alexanderp4580/slonav/parts/Sensor_Bracket.stl

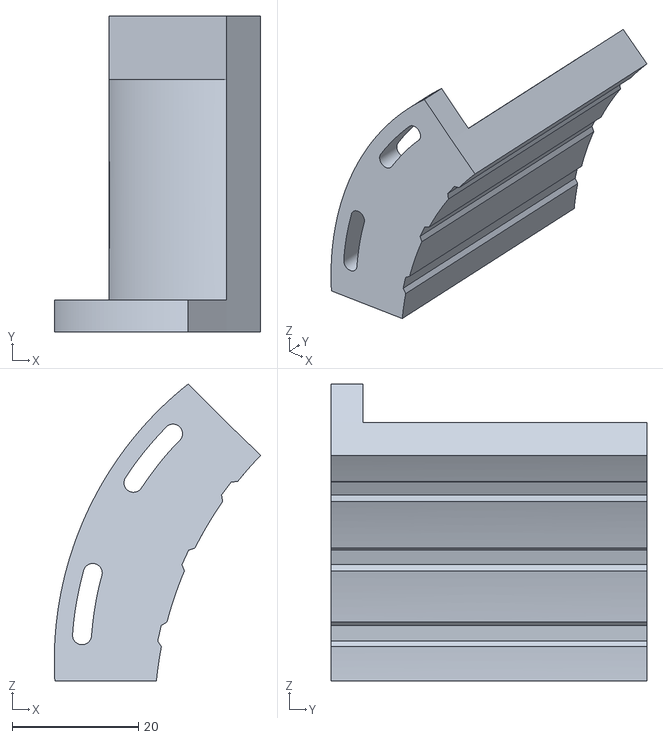
[picture p1: CAD file, 2017-06-05]
parts/Sensor_Bracket.stl
32.7 x 50.0 x 47.1
