alexanderp4580/slonav/parts/Solenoid_Cover_Front.STL

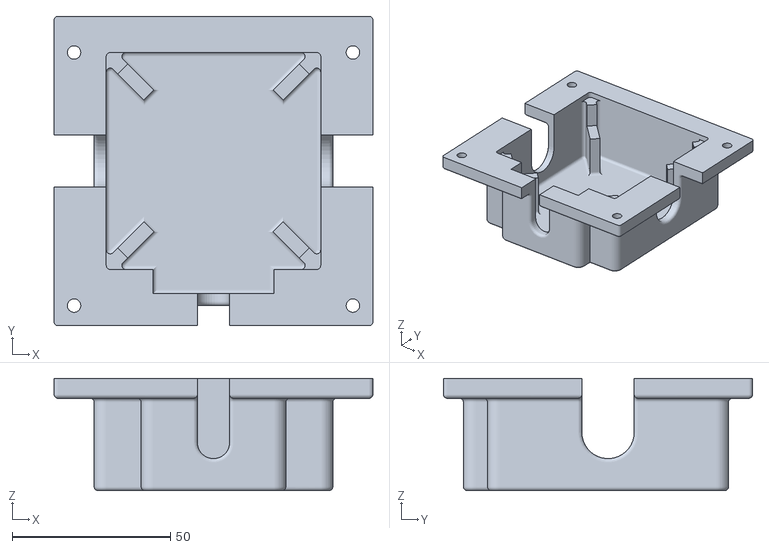
[picture p2: CAD file, 2017-06-05]
parts/Solenoid_Cover_Front.STL
100.8 x 97.8 x 35.6
