alexanderp4580/slonav/parts/Plunger_Mount.STL

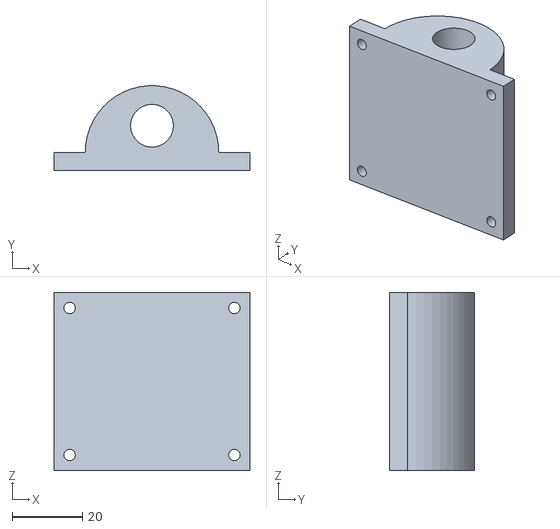
[picture p3: CAD file, 2017-06-05]
parts/Plunger_Mount.STL
55.9 x 24.1 x 50.8
