alexanderp4580/slonav/parts/Servo_Mount.STL

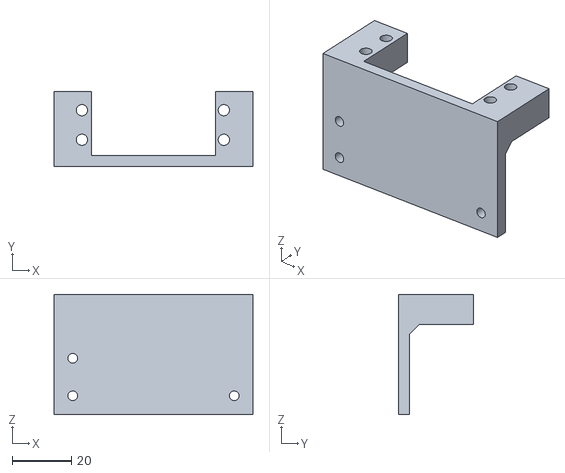
[picture p4: CAD file, 2017-06-05]
parts/Servo_Mount.STL
67.3 x 25.4 x 40.6
