alexanderp4580/slonav/parts/Battery_Wedge.STL

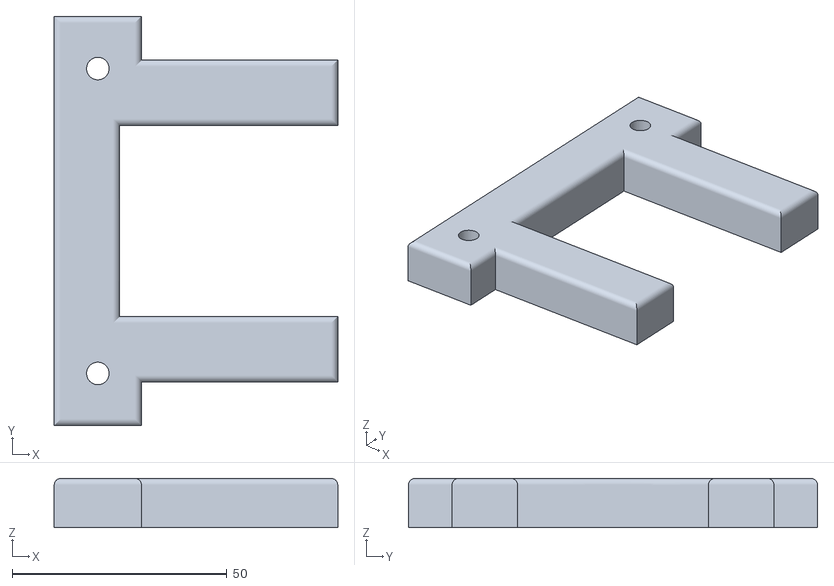
[picture p5: CAD file, 2017-06-05]
parts/Battery_Wedge.STL
66.0 x 95.2 x 11.4
