alexanderp4580/slonav/parts/Solenoid_Cover_Back.STL

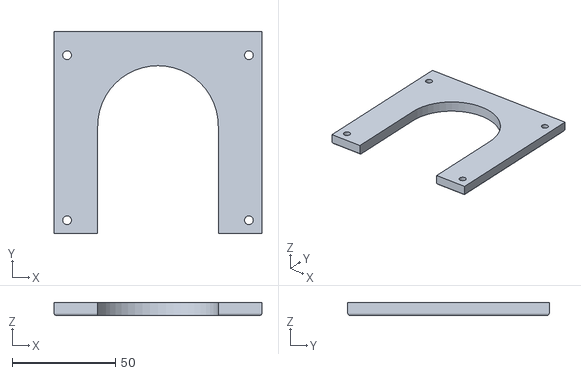
[picture p6: CAD file, 2017-06-05]
parts/Solenoid_Cover_Back.STL
100.8 x 97.8 x 6.35
