alexanderp4580/slonav/software/tests/system/accel_control/test_data/accel_test_data.xlsx

P = 0.1, I = 1.0
Point# | timeElapsed | xAcc | xAcc (corrected) | yAcc | zAcc | heading | pitch | roll | lEncoder | rEncoder | lMotor | rMotor
18 | 0.562389 | -98 | -0.98 | -158 | 1055 | 177.625 | -0.25 | 1.1875 | 0 | 0 | 19.025215 | 19.025215
36 | 1.102567 | 2582 | 25.82 | -2089 | 476 | 177.8125 | 0.1875 | 1.25 | -50 | 0 | 184.23912 | 184.23912
54 | 1.6337 | -1055 | -10.55 | 41 | 808 | 177.9375 | 0.125 | 1.625 | 175 | 0 | 386.248352 | 386.248352
72 | 2.172613 | -141 | -1.41 | -107 | 897 | 178.5 | -0.0625 | 1.75 | 15 | 0 | 542.707458 | 542.707458
90 | 2.70104 | 601 | 6.01 | -237 | 736 | 178.3125 | 0.6875 | 3.1875 | 0 | 0 | 761.897095 | 761.897095
108 | 3.241176 | 1178 | 11.78 | -347 | -381 | 178.75 | 0.25 | 2 | 0 | 0 | 998.721863 | 998.721863
126 | 3.774797 | 1721 | 17.21 | -421 | 492 | 179.375 | 0.875 | 2.5 | 2 | 0 | 1221.629517 | 1221.629517
144 | 4.414334 | -361 | -3.61 | -393 | 1146 | 179.875 | 0.5625 | 2.6875 | 44 | 0 | 1422.994385 | 1422.994385
162 | 4.954563 | -972 | -9.72 | -182 | 813 | 180.125 | 0.4375 | 2.9375 | 85 | 0 | 1616.182007 | 1616.182007
180 | 5.492611 | -271 | -2.71 | -250 | 1631 | 180.0625 | 0.25 | 2.25 | 0 | 0 | 1800.889771 | 1800.889771
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
