alexanderp4580/slonav/software/tests/system/steering_control/test_data/scaled_platform_tests.xlsx

Heading Controlled Steering
Test 1 (Kp = 5.0)
Point# | timeElapsed | gpsDate | gpsTime | lat | long | xAcc | yAcc | zAcc | heading | pitch | roll | lEncoder | rEncoder | lMotor | rMotor | Normalized Heading
18 | 0.532068 | NL | NL | NL | NL | -187 | -153 | 1236 | 157 | -1.375 | -2.9375 | 52 | 0 | 32.687531 | 27.312469 | 0
36 | 1.036135 | NL | NL | NL | NL | -56 | -284 | 1381 | 158 | -1.75 | -2.8125 | 55 | 0 | 28.937531 | 31.062469 | 1
54 | 1.540203 | NL | NL | NL | NL | 268 | -160 | 899 | 158.0625 | -2 | -3.25 | 52 | 0 | 28.000031 | 31.999969 | 1.0625
72 | 2.044269 | NL | NL | NL | NL | -167 | 5 | 1717 | 158.25 | -2.4375 | -3.25 | 53 | 0 | 26.125031 | 33.874969 | 1.25
90 | 2.548327 | NL | NL | NL | NL | -236 | -22 | 798 | 158.125 | -1.75 | -3.125 | 53 | 0 | 27.375031 | 32.624969 | 1.125
108 | 3.052388 | NL | NL | NL | NL | 109 | -155 | 948 | 158.3125 | -1.4375 | -2.375 | 51 | 0 | 26.437531 | 33.562469 | 1.3125
126 | 3.556449 | NL | NL | NL | NL | 181 | -171 | 351 | 158.4375 | -1.4375 | -2.125 | 53 | 0 | 25.812531 | 34.187469 | 1.4375
144 | 4.107152 | NL | NL | NL | NL | 26 | -39 | 882 | 158.875 | -1.25 | -2.3125 | 49 | 0 | 23.312531 | 36.687469 | 1.875
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
