alexanderp4580/slonav/SLONav_Poster.pdf

## Project Description

## Engineering Specifications

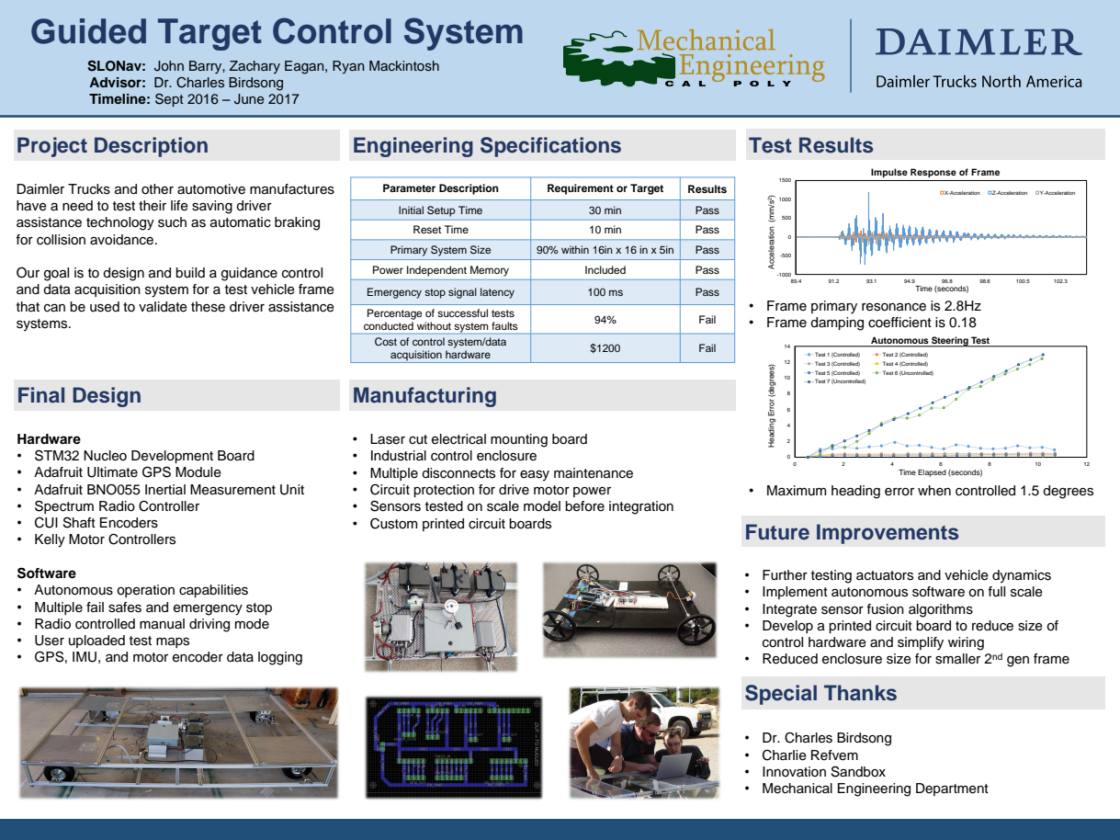
[picture p7: page 1]
Manufacturing; Final Design; Future Improvements; Test Results; Test 1 (Controlled); Test 2 (Controlled); Test 3 (Controlled); Test 4 (Controlled); Test 5 (Controlled); Test 6 (Uncontrolled); Test 7 (Uncontrolled); Acceleration (mm/s; Time (seconds); X-Acceleration; Z-Acceleration; Y-Acceleration

Guided Target Control System

SLONav: John Barry, Zachary Eagan, Ryan Mackintosh
Advisor: Dr. Charles Birdsong
Timeline: Sept 2016 – June 2017

Impulse Response of Frame

Daimler Trucks and other automotive manufactures
have a need to test their life saving driver
assistance technology such as automatic braking
for collision avoidance.

Parameter Description | Requirement or Target | Results

Initial Setup Time | 30 min | Pass

Reset Time | 10 min | Pass

Primary System Size | 90% within 16in x 16 in x 5in | Pass

Power Independent Memory | Included | Pass

Our goal is to design and build a guidance control
and data acquisition system for a test vehicle frame
that can be used to validate these driver assistance
systems.

Emergency stop signal latency | 100 ms | Pass

• Frame primary resonance is 2.8Hz
• Frame damping coefficient is 0.18

Percentage of successful tests conducted without system faults | 94% | Fail

Autonomous Steering Test

Cost of control system/data acquisition hardware | $1200 | Fail

Heading Error (degrees)

Hardware
• STM32 Nucleo Development Board
• Adafruit Ultimate GPS Module
• Adafruit BNO055 Inertial Measurement Unit
• Spectrum Radio Controller
• CUI Shaft Encoders
• Kelly Motor Controllers

• Laser cut electrical mounting board
• Industrial control enclosure
• Multiple disconnects for easy maintenance
• Circuit protection for drive motor power
• Sensors tested on scale model before integration
• Custom printed circuit boards

Time Elapsed (seconds)

• Maximum heading error when controlled 1.5 degrees

Software
• Autonomous operation capabilities
• Multiple fail safes and emergency stop
• Radio controlled manual driving mode
• User uploaded test maps
• GPS, IMU, and motor encoder data logging

• Further testing actuators and vehicle dynamics
• Implement autonomous software on full scale
• Integrate sensor fusion algorithms
• Develop a printed circuit board to reduce size of
control hardware and simplify wiring
• Reduced enclosure size for smaller 2
Special Thanks

nd gen frame

• Dr. Charles Birdsong
• Charlie Refvem
• Innovation Sandbox
• Mechanical Engineering Department
