alexanderp4580/slonav/schematics/Connector Board/Connector Board.brd

## EAGLE design schematics/Connector Board/Connector Board.brd (2017-06-05)

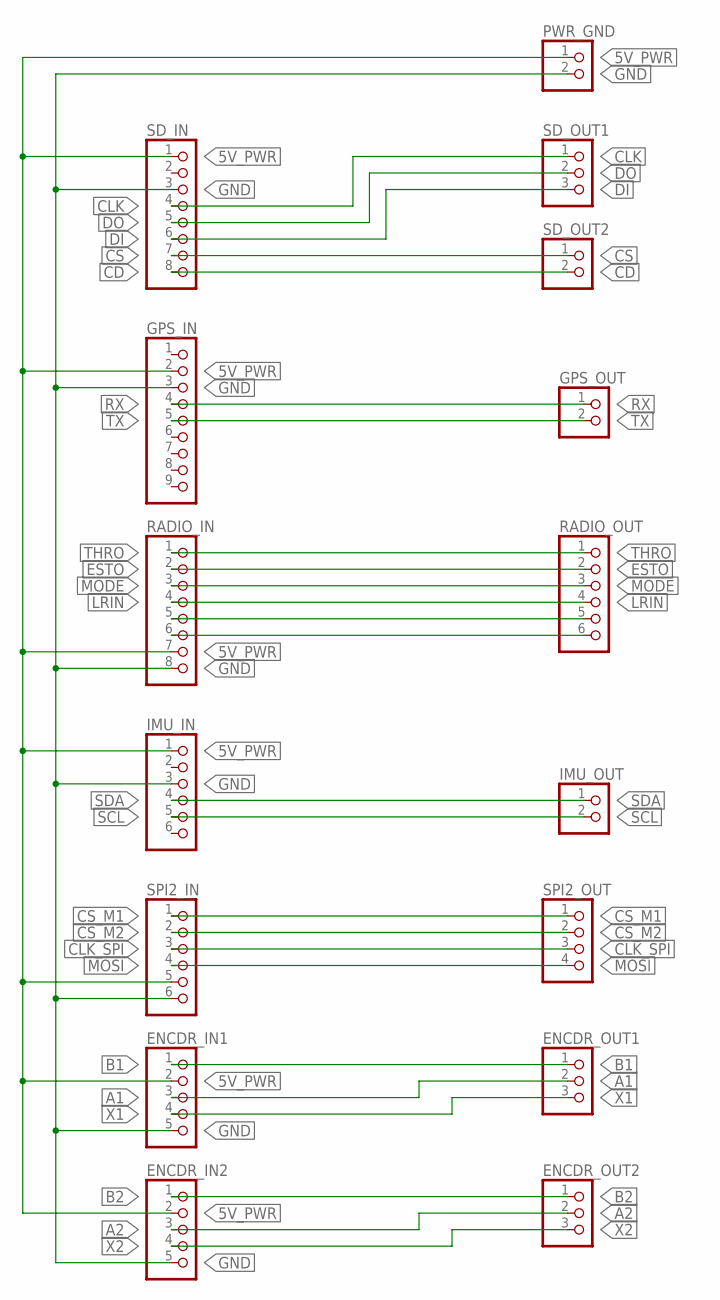
[picture p8: schematic Connector Board.sch]

Parts:
ENCDR_IN1, ENCDR_IN2: PINHD-1X5; 1X05
ENCDR_OUT1, ENCDR_OUT2: PINHD-1X3; 1X03
GPS_IN: PINHD-1X9; 1X09
GPS_OUT: PINHD-1X2; 1X02
IMU_IN: PINHD-1X6; 1X06
IMU_OUT: PINHD-1X2; 1X02
PWR_GND: PINHD-1X2; 1X02
RADIO_IN: PINHD-1X8; 1X08
RADIO_OUT: PINHD-1X6; 1X06
SD_IN: PINHD-1X8; 1X08
SD_OUT1: PINHD-1X3; 1X03
SD_OUT2: PINHD-1X2; 1X02
SPI2_IN: PINHD-1X6; 1X06
SPI2_OUT: PINHD-1X4; 1X04

Connections:
5V_PWR: ENCDR_IN1.2, ENCDR_IN2.2, GPS_IN.2, IMU_IN.1, PWR_GND.1, RADIO_IN.7, SD_IN.1, SPI2_IN.5
A1: ENCDR_IN1.3, ENCDR_OUT1.2
A2: ENCDR_IN2.3, ENCDR_OUT2.2
B1: ENCDR_IN1.1, ENCDR_OUT1.1
B2: ENCDR_IN2.1, ENCDR_OUT2.1
CD: SD_IN.8, SD_OUT2.2
CLK: SD_IN.4, SD_OUT1.1
CLK_SPI: SPI2_IN.3, SPI2_OUT.3
CS: SD_IN.7, SD_OUT2.1
CS_M1: SPI2_IN.1, SPI2_OUT.1
CS_M2: SPI2_IN.2, SPI2_OUT.2
DI: SD_IN.6, SD_OUT1.3
DO: SD_IN.5, SD_OUT1.2
ESTO: RADIO_IN.2, RADIO_OUT.2
GND: ENCDR_IN1.5, ENCDR_IN2.5, GPS_IN.3, IMU_IN.3, PWR_GND.2, RADIO_IN.8, SD_IN.3, SPI2_IN.6
LRIN: RADIO_IN.4, RADIO_OUT.4
MODE: RADIO_IN.3, RADIO_OUT.3
MOSI: SPI2_IN.4, SPI2_OUT.4
unnamed: RADIO_IN.5, RADIO_OUT.5
unnamed: RADIO_IN.6, RADIO_OUT.6
RX: GPS_IN.4, GPS_OUT.1
SCL: IMU_IN.5, IMU_OUT.2
SDA: IMU_IN.4, IMU_OUT.1
THRO: RADIO_IN.1, RADIO_OUT.1
TX: GPS_IN.5, GPS_OUT.2
X1: ENCDR_IN1.4, ENCDR_OUT1.3
X2: ENCDR_IN2.4, ENCDR_OUT2.3

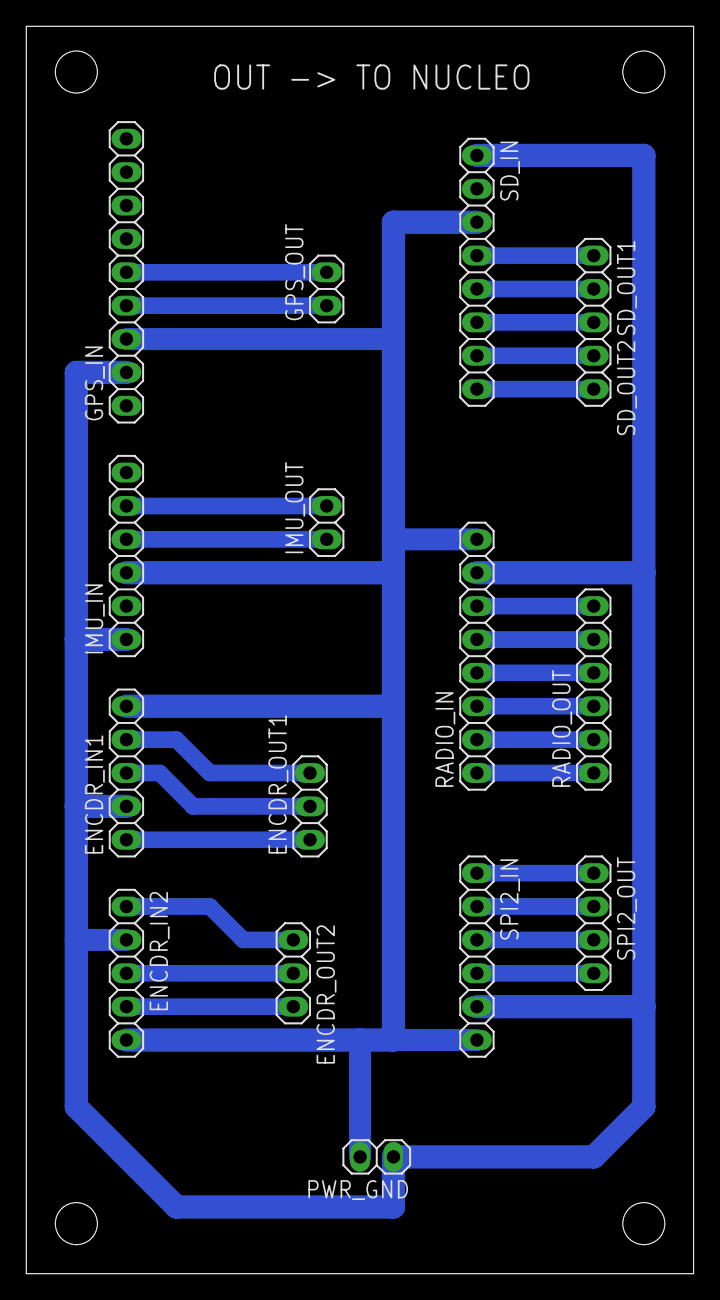
[picture p9: board Connector Board.brd from above]

Board: 2 copper layers, 50.8 x 94.9 mm, 16 parts (0 on the bottom side), 27 nets.
