alexanderp4580/slonav/schematics/DAC_Board/dac_board.brd

## EAGLE design schematics/DAC_Board/dac_board.brd (2017-06-05)

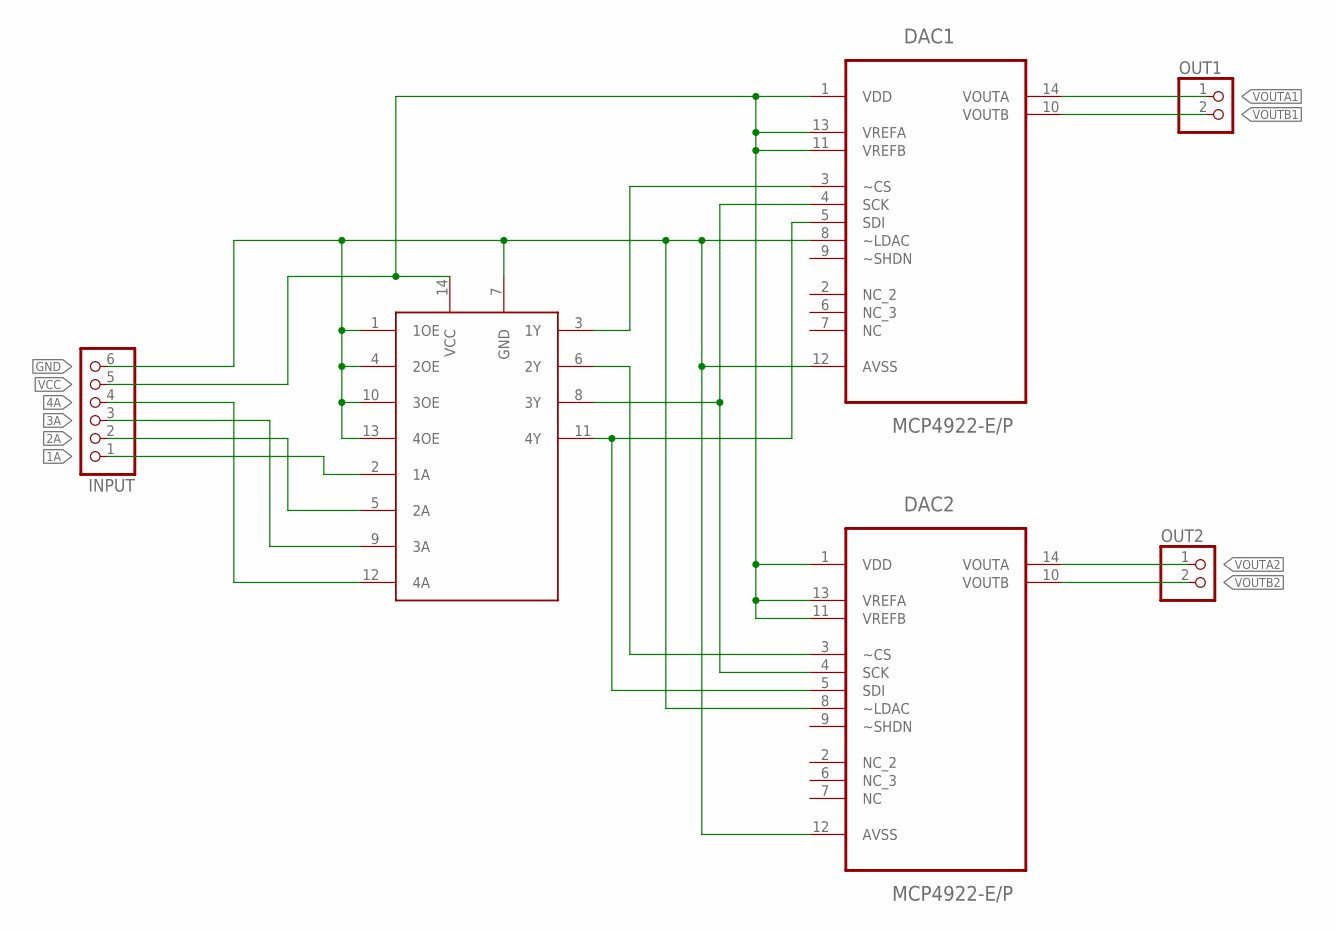
[picture p10: schematic dac_board.sch]

Parts:
DAC1, DAC2: MCP4922-E/P; DIP254P762X533-14
INPUT: PINHD-1X6; 1X06
LLS: SN74AHCT125; DIP762W46P254L1930H508Q14
OUT1, OUT2: PINHD-1X2; 1X02

Connections:
1A: INPUT.1, LLS.2 (1A)
1Y: DAC1.3 (~CS), LLS.3 (1Y)
2A: INPUT.2, LLS.5 (2A)
2Y: DAC2.3 (~CS), LLS.6 (2Y)
3A: INPUT.3, LLS.9 (3A)
3Y: DAC1.4 (SCK), DAC2.4 (SCK), LLS.8 (3Y)
4A: INPUT.4, LLS.12 (4A)
4Y: DAC1.5 (SDI), DAC2.5 (SDI), LLS.11 (4Y)
GND: DAC1.8 (~LDAC), DAC1.12 (AVSS), DAC2.8 (~LDAC), DAC2.12 (AVSS), INPUT.6, LLS.1 (1OE), LLS.4 (2OE), LLS.7 (GND), LLS.10 (3OE), LLS.13 (4OE)
VCC: DAC1.1 (VDD), DAC1.11 (VREFB), DAC1.13 (VREFA), DAC2.1 (VDD), DAC2.11 (VREFB), DAC2.13 (VREFA), INPUT.5, LLS.14 (VCC)
VOUTA1: DAC1.14 (VOUTA), OUT1.1
VOUTA2: DAC2.14 (VOUTA), OUT2.1
VOUTB1: DAC1.10 (VOUTB), OUT1.2
VOUTB2: DAC2.10 (VOUTB), OUT2.2

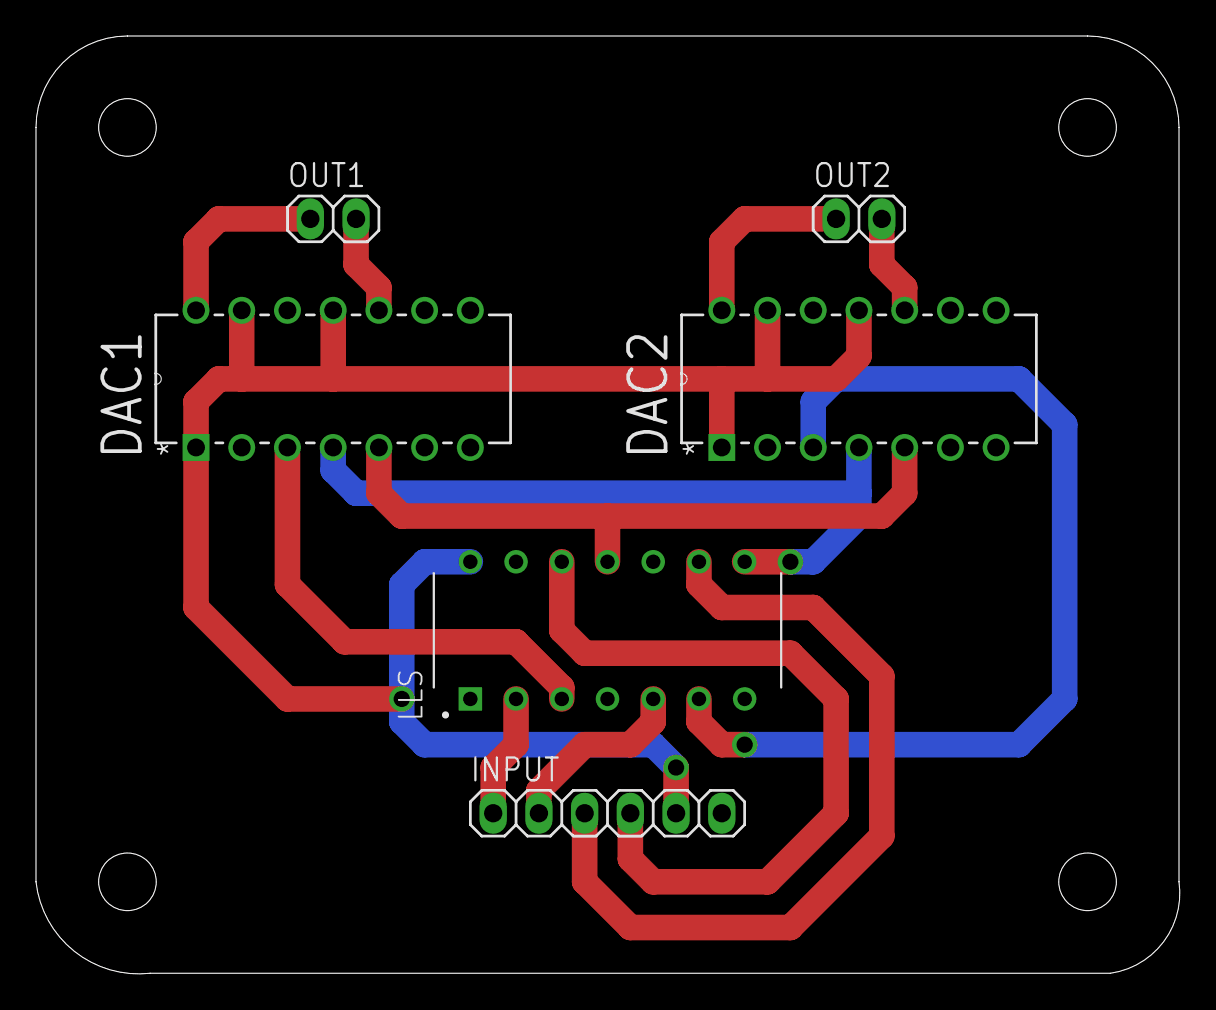
[picture p11: board dac_board.brd from above]

Board: 2 copper layers, 63.5 x 52.1 mm, 6 parts (0 on the bottom side), 14 nets.
