alexanderp4580/slonav/software/tests/system/skeleton/constants.h

/**
 * Provides global constants for all top level functions
 **/

/**********************************************************/
/******************      Strings        *******************/  
const int Max_Buff = 200;



 
/**********************************************************/
/******************       Motor PID     *******************/  
const float KO = 0;

 
/**********************************************************/
/******************      Strings        *******************/  




 
/**********************************************************/
/******************      Strings        *******************/  





 
/**********************************************************/
/******************      Strings        *******************/   
