alexanderp4580/slonav/(commit log)

2017-01-30 Created electrical echematic file (incomplete)
    [MESP_0_1.sch]
2017-01-30 Added test program for sensor integration. Currently just IMU
2017-01-30 Finished Schematic Overview Drawing for CDR
    [MESP_0_1.sch]
2017-02-03 Added rest of vehicle model and modified motor models
2017-02-05 Went with skid steering model with no modification. Started steering control loop
2017-02-05 Steering control is WIP
2017-02-06 Added Motor controller and analog input for brake
    [MESP_0_2.sch]
2017-02-07 Fixed steering model, WOoOoOoOoOo
2017-02-08 Final version of steering model for CDR
2017-02-08 Added some stuff for velocity control
2017-02-23 Removed old code, added directory for schematics
    [MESP_0_1.sch]
2017-02-27 Added imu driver files from old project
2017-02-28 Worked on IMU driver, currently not working
    [imu.cpp, imu.h, main.cpp]
2017-03-03 Fixed drivers and test file. Still needs comments
    [imu.cpp, imu.h, main.cpp]
2017-03-05 Added files for motor testing on scale model
2017-03-06 Got motor driver working, encoder and pid need to be written
2017-03-07 added test file for integrateing motors and sensors
2017-03-07 Added PID and encoder libraries. Wrote basic test for encoders.
2017-03-07 working through building the test but I think i broke it
    [imu.cpp, imu.h, main.cpp, motor.cpp, motor.h]
2017-03-08 Added system test file. Works except for we have a pin conflict
2017-03-12 Changed some stuff, added files for sensor fusion to test
    [gps.csv, results.csv]
2017-03-12 Removed some unnecessary files and began implementing TinyEKF
    [gps.csv, results.csv]
2017-03-16 Started adding some stuff for PID control of motors
2017-04-09 Got SD card working with platform. Test code write some readings from IMU.
2017-04-12 added test file for sd card and all sensors and the motors
2017-04-13 Fixed data test file.
    [main.cpp]
2017-04-13 Changed the data collection program to show some behavior of final design
    [first full test with gps.ods]
2017-04-17 Added files and began working on sensor fusion code
2017-04-17 Added folders for steering control and acceleration control testing
2017-04-24 Steering test ready for evaluation
2017-04-29 somthing branchy happened, moved mapp functions to seperate files
    [first full test with gps.ods]
2017-04-30 Started implementing EKF sensor fusion
2017-04-30 broken skeleton I need real food that sandwhich was empty
    [main.cpp]
2017-05-14 Changed PID controller class
2017-05-14 Updated pinout and wrote test for kelly motor controller hardware
2017-05-19 Tested DAC board
2017-05-22 Added some pins for final brake driver
2017-05-22 Wrote class for controlling linear actuator
2017-05-22 Added code for braking actuator
2017-05-26 Changed encoder reading function. Added full brake when emergency brake is actuated.
2017-05-27 Failed track day code
    [main.cpp]
2017-05-29 Got steering control working
2017-05-29 Implemented different driver for GPS. Added data logging to steering control test.
2017-05-30 Wrote acceleration control (doesn't work well at all)
    [main.cpp]
2017-06-05 Added useful documentation
    [Battery_Wedge.STL, Connector Board.brd, Connector Board.sch, MESP_0_1.sch, MESP_0_2.sch, Plunger_Mount.STL, Sensor_Bracket.stl, Servo_Mount.STL]
